pzfreo/purfroller/u_frame_iso.png

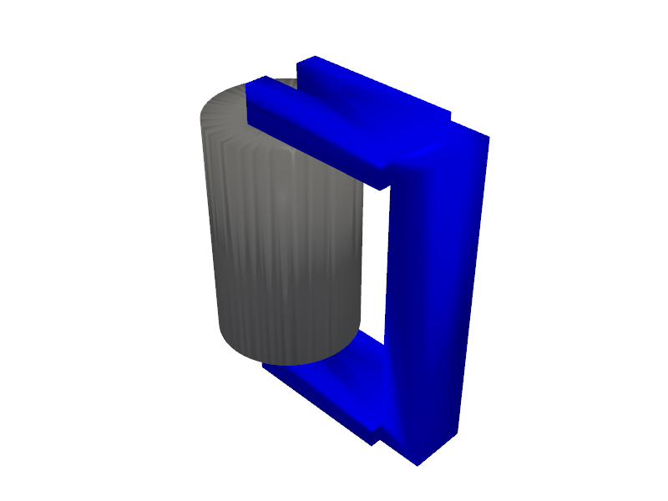
u_frame_iso.png
