pzfreo/purfroller/u_frame_slot_view.png

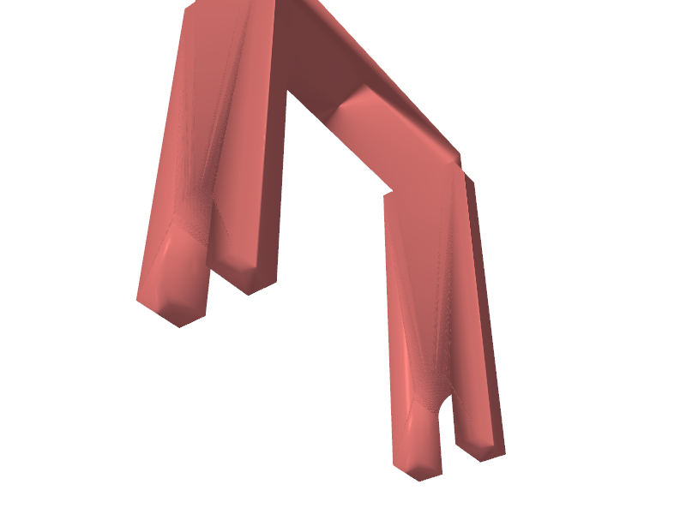
u_frame_slot_view.png
