pzfreo/purfroller/u_frame.stl

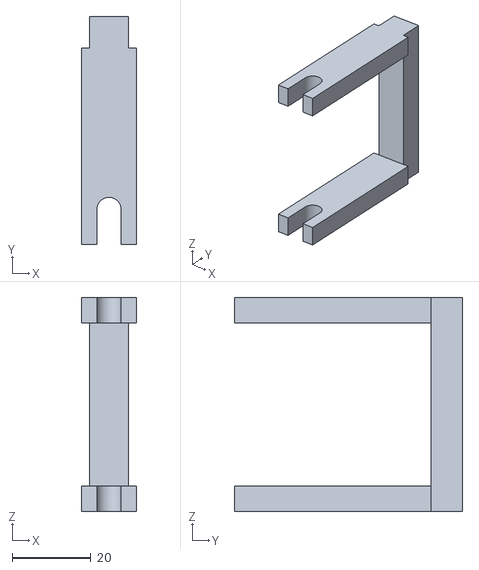
[picture p3: CAD file, 2026-05-02]
u_frame.stl
14.0 x 58.0 x 54.5
