pzfreo/purfroller/roller.stl

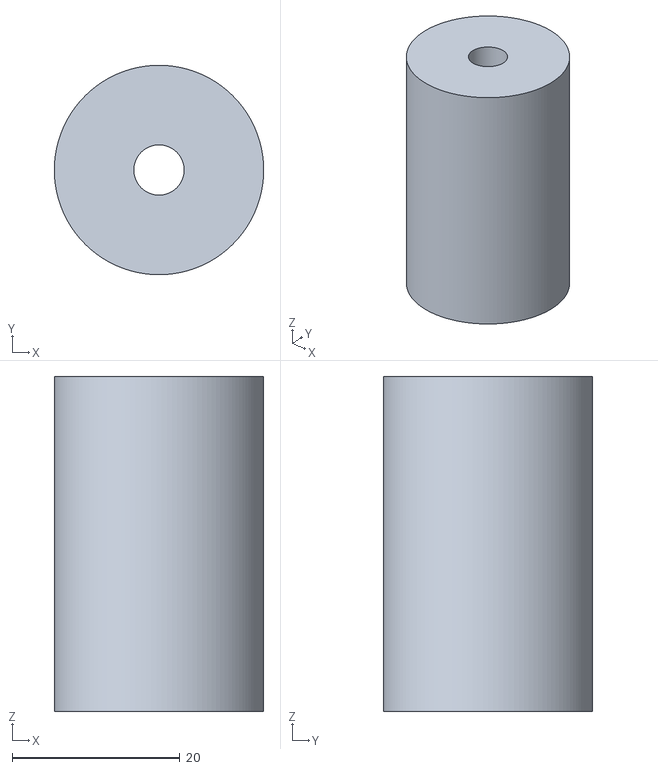
[picture p4: CAD file, 2026-05-02]
roller.stl
25.0 x 25.0 x 40.0
