pzfreo/purfroller/(commit log)

2026-04-26 Add initial design spec for purfling roller
    Documents the design agreed in conversation: nylon-printed roller device
    with adjustable gap for compressing laminated purfling strips.
2026-04-26 Update roller width to 40mm
    Wider rollers give better support and more even pressure across the purfling strip.
    Overall device width updated to ~56mm accordingly.
2026-04-27 Redesign to fixed upper roller / adjustable lower roller, add U-frame dimensions
    Inverts the original concept: upper roller is now fixed and driven, lower roller
    rides in an inverted U-frame adjusted from below by M6 bolts. Gravity provides
    the return force, eliminating the need for springs. Device sits on a 20mm stand
    to give thumbwheel access from below.
    Derives and records U-frame dimensions from first principles: 41mm inside width,
    7×14mm arm cross-section, 25mm arm height, 8mm crossbar — 33mm overall.
2026-04-30 Add magnetic thickness gauge design spec
    Documents the design for a one-sided thickness gauge using Hall sensors,
    ADS1115 ADC, and XIAO ESP32S3, with multi-sensor auto-calibration.
2026-05-01 Add MCP config for build123-mcp CAD server
    Connects the build123d Python CAD server so Claude can execute
    build123d code, render models, measure geometry, and export files.
2026-05-01 Add build123d model for roller and U-frame with STL exports
    Implements the two core moving parts from the purfling roller spec:
    - roller: 25mm dia × 40mm, 6mm axle bore
    - u_frame: single-piece with arms at ±24mm (fits 8mm side plates),
    open-bottom axle slots, top crossbar with M6 bearing pads
    Overall U-frame Z span = 56mm, matching spec's device width.
    [roller.stl, u_frame.stl]
2026-05-01 Strengthen U-frame axle slot: deeper arms, tighter fit, U-shaped profile (#3)
    - arm_x_d 12 → 14mm: gives 3.95mm wall each side of the 6.1mm slot
    - slot_w 6.5 → 6.1mm: tighter clearance on 6mm axle rod
    - Slot profile changed from rectangular to U-shaped (rect + semicircular cap)
    so the axle seats in a matching curved surface rather than a flat bottom
    - Add CLAUDE.md with project instructions: talk before coding, use build123d MCP server
    [u_frame.stl]
2026-05-02 Shorten U-frame arms to 5mm clearance above roller (#4)
    * Add magnetic thickness gauge design spec
    * Add MCP config for build123-mcp CAD server
    * Add build123d model for roller and U-frame with STL exports
    - roller: 25mm dia × 40mm, 6mm a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
    [roller.stl, u_frame.stl]
2026-05-03 Widen crossbar to 25 mm with stepped profile preserving 14 mm arm width (#5)
    Crossbar now has a 25 mm wide boss in the Z-gap between the arms but
    narrows to arm_x_d (14 mm) directly above each arm so the arms can
    slip-fit into the receiving slot in the mating part. A flat 25 mm
    crossbar would have overhung the arms in X and snagged the slot mouth.
2026-05-03 Align main with inverted-U-frame redesign and Z-up coords (#7)
    * Redesign to fixed upper roller / adjustable lower roller, add U-frame dimensions
    * Align model and spec with as-built U-frame: Z-up coords,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
2026-05-03 Add axle model and position roller at correct assembly height
    - Derive axle_z (25.55 mm) explicitly from slot geometry so the
    assembly height is a named, traceable parameter rather than implicit
    - Move roller to axle_z so it renders at the correct position relative
    to the U-frame (previously sat at Z=0, causing apparent interference)
    - Add axle cylinder (Ø6 mm × 64 mm) as a named part for assembly
    visualisation and interference checking
2026-05-03 Shorten roller to 36mm and add thrust washers
    Roller was 40mm, leaving zero clearance between its end face and the
    side plate inner face. With 0.75mm Y play in the arm slot this would
    cause the roller to rub the plate.
    Fix: shorten roller_len to 36mm and add 2mm thrust washers (Ø12mm,
    washer_t/washer_od params) between each roller end and the side plate.
    arm_y formula updated to include washer_t so arm_y stays at 24mm and
    axle_len stays at 64mm — downstream geometry unchanged.
    Each washer is constructed as a fresh expression to avoid build123d's
    in-place move() mutating a shared base shape.
2026-05-03 Switch axle diameter from 6mm to 4mm rod
    axle_dia 6→4, slot_w 6.1→4.1 (0.1mm clearance maintained).
    Side-effects:
    - axle_z shifts from 25.55→24.55mm (slot cap radius shrinks)
    - Crossbar-to-roller clearance drops from ~5mm to ~4.05mm
    - Arm wall each side of slot increases from 3.95→4.95mm
    - axle_len unchanged at 64mm; arm_y unchanged at 24mm
    Updated inline comments to match new values.
2026-05-03 Add outer frame: side plates, top crossbar, upper roller assembly
    New parts:
    - sp_r / sp_l: flat side plates (22×8×72mm) at Y=±arm_y with a
    14.2mm arm guide slot through full Y thickness (open at base) and
    a Ø4.2mm upper axle hole at Z=upper_axle_z. M3 bolt holes TBD.
    - xbar_top: top crossbar (22×40×14mm) centred on upper_axle_z,
    spanning the inner faces of the side plates, with upper axle bore.
    M3 inserts TBD.
    - upper_roller / upper_axle / upper_washer_r / upper_washer_l:
    identical geometry to lower set, positioned at upper_axle_z=54.55mm
    (gives 0mm gap at max U-frame push, 5mm gap at rest).
    New derived parameters: upper_axle_z, frame_x_d, frame_z_h,
    arm_slot_x, arm_slot_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
2026-05-03 Fix two interferences in outer frame assembly
    1. upper_roller vs xbar_top (10,542 mm³): crossbar was centred on the
    upper axle and the roller body crashed through it. Moved xbar_top to
    the top of the frame (Z=68–80mm, above roller top at ~67mm) and
    removed the redundant axle bore (upper axle is held by side plate holes).
    Extended frame_z_h to 80mm to give room.
    2. u_frame vs sp_r/sp_l (46.8 mm³): side plates started at Z=0, so the
    U-frame crossbar (Z=0–8mm) overlapped the plate inner face. Plates now
    start at Z=xbar_h (8mm); the crossbar hangs below without clashing.
    arm_slot_z corrected to 37mm (measured from the new plate base).
    All interference checks pass wit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
2026-05-03 Add lower crossbar with M6 height-adjustment holes and extend side plates
    - New xbar_bot sits below the U-frame crossbar (Z=-15 to Z=0), with two
    M6 tapped holes at ±8mm X so bolts can push up on the U-frame from below.
    - Side plates extended downward by xbar_bot_h (15mm) to enclose the full
    assembly range, with arm guide slot kept correctly placed in world Z.
    - Remove arm_y_inner variable; inline the equivalent expression in xbar_mid.
2026-05-04 Add fastening, adjustment, and clamping features to outer frame
    - M3 heat-set inserts in both crossbars (5mm OD, 4.7mm hole, chamfered
    entry, 8mm clearance tail) with matching M3 clearance holes through
    side plates — 2 bolts per crossbar end
    - Replace dual offset M6 holes with single central M6 heat-set insert
    in lower crossbar (8mm OD × 10mm, pressed from below, 6.2mm clearance
    through to top for bolt tip)
    - Extend side plates 30mm below lower crossbar for open bolt-access pocket
    - Add L-shaped G-clamp flanges (40mm wide × 10mm thick) at plate base,
    extending outward on each side for table clamping
2026-05-04 Add crank handle assembly for upper roller drive
    - Extend upper axle to 86mm (15mm stubs each side, up from 4mm) to
    give sufficient grip length for crank hub
    - Crank hub (16mm OD × 15mm): sits on right axle stub, M3 heat-set
    insert from hub top face clamps onto a flat filed on the axle rod
    - Crank arm: 40mm from axle centre to handle bore, 15mm wide, 10mm tall
    - Handle (16mm OD × 30mm, peg-turner style): post (10mm OD × 8.3mm)
    spins freely in 10.4mm bore at arm end; 14mm flange retains it on
    the outer side
    - Retaining washer (14mm OD × 4mm): held by M3 bolt into heat-set
    insert in post tip
2026-05-04 Fix crank geometry: handle-end boss, flange and washer positions
    - Add circular boss at handle end of arm (matches hub, gives strength
    and a proper bearing surface for the handle post)
    - Move handle flange outside the arm outer face (was recessed inside,
    providing no axial retention)
    - Move handle body to start after the flange, not at the arm face
    - Move retaining washer to arm inner face (was floating inside the arm
    at the wrong Y position)
2026-05-04 Add estampo build pipeline for automated slicing (#15)
    - export_parts.py: exports all 14 printed parts from purfroller.py as
    STEP files to parts/ (gitignored — generated at build time)
    - estampo.toml: OrcaSlicer pipeline targeting Bambu Lab P1S 0.4 nozzle,
    Textured PEI Plate, Generic PETG, 0.20mm Strength process.
    Overrides: 5 walls, 40% gyroid infill, 6 top/bottom layers.
    Pack stage produces .gcode.3mf for Bambu Connect.
    - profiles/: pinned machine, process, and filament profiles for
    reproducible slicing across machines and CI
    - .github/workflows/slice.yml: exports parts and runs full estampo
    pipeline on every push/PR; posts print metrics as PR comment
    - .gitignore: excludes p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
2026-05-04 Fix print orientations and replace blind HS holes with through-bores (#16)
    - estampo.toml: set rotate/orient per part so all 14 parts arrive at the
    slicer in their optimal print orientation (cylinders upright, flat parts
    flat, side plates standing on flange base)
    - purfroller.py: replace _hs_side_cutters (blind pockets from each face)
    with _hs_through_cutters (single through-bore per bolt position, chamfered
    at both ends) so xbar_top and xbar_bot can print upright with no supports
2026-05-04 Fix u_frame disconnected crossbar, handle bore, post length, and side-plate orientation (#17)
    * Fix u_frame disconnected crossbar, handle bore and post length, sp orientation
    u_frame: xbar was three separate unconnected bodies (xbar_mid had a 1.25mm gap
    from the arm-end sections). Replace with spine+boss design: narrow spine runs
    full Y length to connect everything, wide boss covers the central gap region.
    Handle: _post_insert used align=MIN on a rotated cylinder which placed the bore
    in the wrong direction (outside the post body entirely). Fix by centering the
    cylinder correctly at post_tip_y + (insert_len+1)/2. Also extend post_len from
    8.3mm to hub_len=15mm so the post spans the full bo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
2026-05-04 Fix M6 cutter aliasing (only one hole was being cut) (#18)
    * Fix M6 cutter aliasing: build two cutters with a factory function
    build123d's .move() mutates the shape in-place and returns self.
    Reusing _m6_hs_cutter for both cutters meant the second .move()
    cancelled the first, leaving both at Y=0 (one hole instead of two).
    Replace with _make_m6_cutter(y_off) which constructs a fresh shape on
    each call, so ±m6_y_off positions are independent.
    * Widen rollers and crossbars to 60mm span; M6 bolts at ±15mm
    roller_len 36→56mm so arm_y becomes 34mm and xbar_top_y becomes 60mm.
    This gives enough room between the M6 adjustment bolts t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
2026-05-04 Expand rollers to 30mm OD and derive frame height automatically
    roller_dia bumped from 25mm to 30mm. upper_axle_z picks up the change
    automatically (axle_z + 5mm gap + roller_dia). Replaced hard-coded
    frame_z_h=80mm with a derived expression so top-crossbar clearance stays
    5mm above the upper roller regardless of roller_dia. Removed duplicate
    xbar_bot_h assignment left over from the parameter reorder.
2026-05-04 Fix 5mm clearance below lower roller; export assembly STEP
    arm_h raised from 26.5mm to 30.0mm so the lower roller bottom sits
    5.05mm above the U-frame crossbar top (was 1.55mm — nearly touching
    after the roller_dia expansion to 30mm). All outer frame heights
    derive automatically so no other constants needed changing.
    export_parts.py now also writes parts/assembly.step combining all
    14 parts into a single compound for inspection.
2026-05-04 Add thumbwheel design file and spec
    25mm OD × 10mm thumb wheel for M6 flat-head bolt height adjustment.
    Spec: 9 vertical grip flutes, conical countersink (12mm OD, 4mm deep),
    printed M6 internal thread via bd_warehouse IsoThread.
2026-05-04 Complete thumbwheel: fix blocked bore, add lead-in chamfer, fillet edges, balance flutes
    - Fix IsoThread end-cap bug: add explicit bore cylinder (5mm, standard M6 tap
    drill) so the hole is open at both faces
    - Add 1.5mm conical lead-in chamfer at the bottom entry for easy bolt start
    - Fillet outer rim edges 1.5mm and flute-bottom edges 0.6mm for comfortable grip
    - Narrow flute cutter radius 3.5mm → 2.0mm so lobes and grooves are equal width
